fabiobaltieri/quakelight/hardware/quakelight.kicad_pcb

## KiCad design hardware/quakelight.kicad_pcb (2025-12-25)

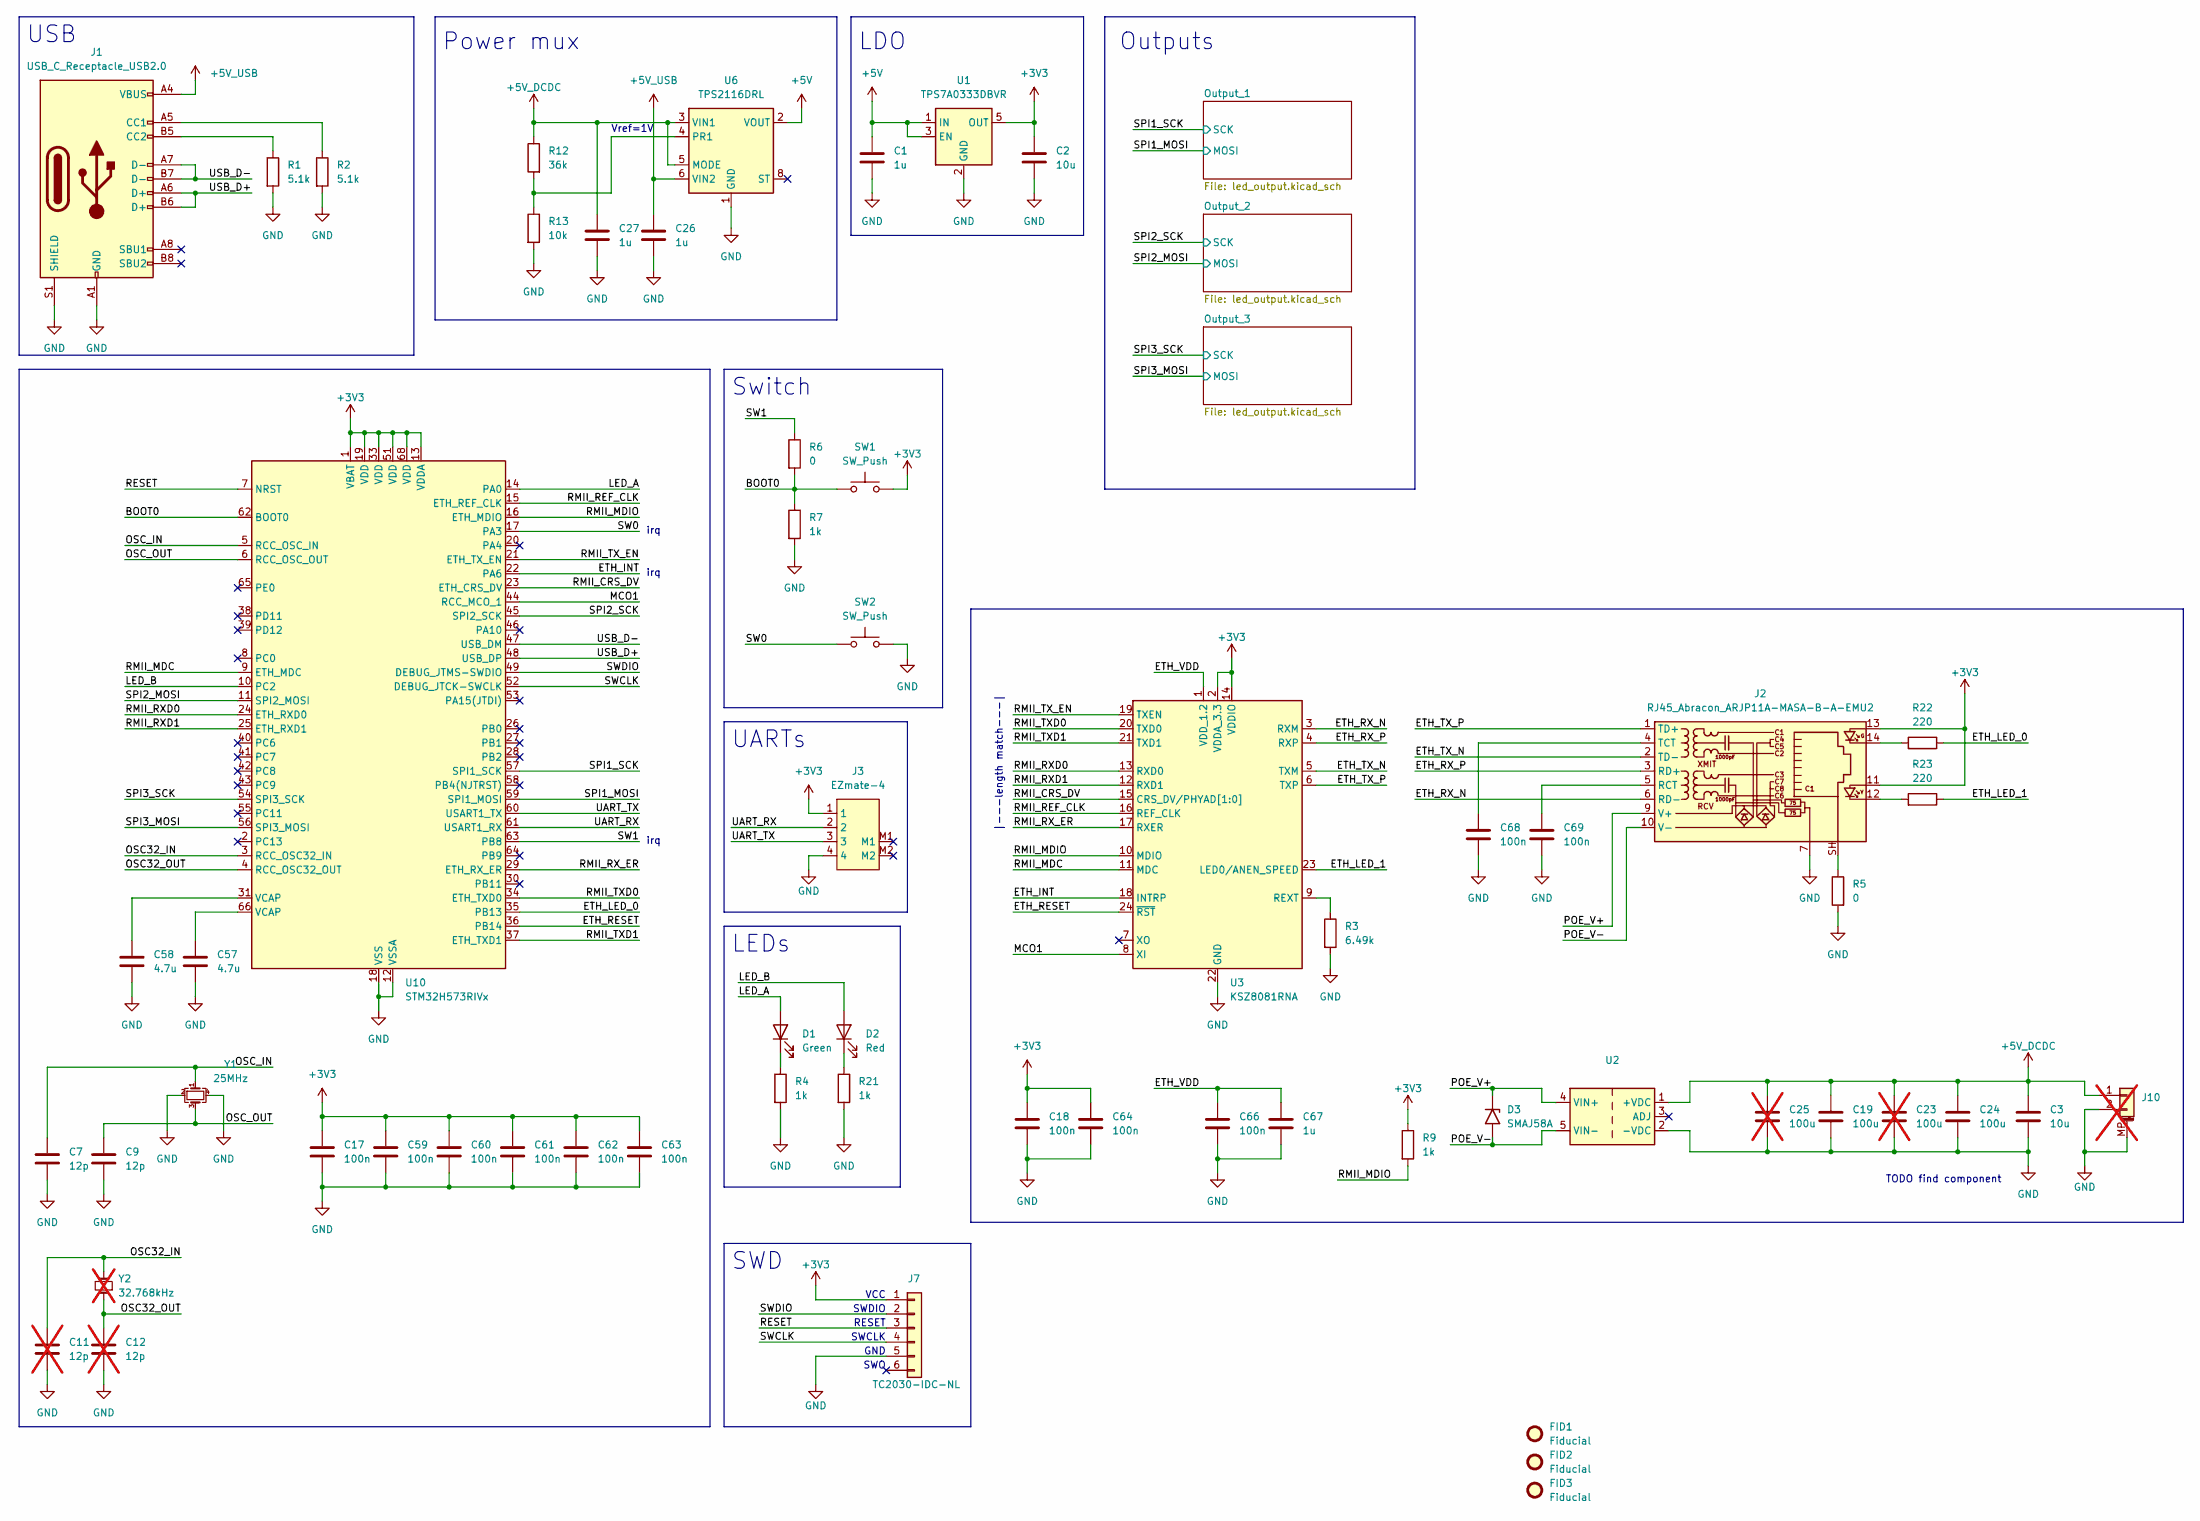
[picture p1: schematic quakelight.kicad_sch]

Parts:
C1, C26, C27, C67: 1u; C_0402_Worthington
C2, C3: 10u; C_0402_Worthington
C7, C9: 12p; C_0402_Worthington
C11, C12: 12p; C_0402_Worthington; not fitted
C17, C18, C59, C60, C61, C62, C63, C64, C66, C68, C69: 100n; C_0402_Worthington
C19, C24: 100u; C_1206_3216Metric
C23, C25: 100u; C_1206_3216Metric; not fitted
C57, C58: 4.7u; C_0402_Worthington
D1: Green; LED_0402_Worthington
D2: Red; LED_0402_Worthington
D3: SMAJ58A; D_SMA
FID1, FID2, FID3: Fiducial; Fiducial_0.75mm_Mask1.5mm
J1: USB_C_Receptacle_USB2.0; USB_C_Receptacle_JAE_DX07S016JA1R1500
J2: RJ45_Abracon_ARJP11A-MASA-B-A-EMU2; RJ45_Abracon_ARJP11A-MA_Horizontal
J3: EZmate-4
J7: TC2030-IDC-NL; Tag-Connect_TC2030-IDC-NL_2x03_P1.27mm_Vertical
J10: Conn_01x02_MountingPin; JST_PH_S2B-PH-SM4-TB_1x02-1MP_P2.00mm_Horizontal; not fitted
R1, R2: 5.1k; R_0402_Worthington
R3: 6.49k; R_0402_Worthington
R4, R7, R9, R21: 1k; R_0402_Worthington
R5: 0; R_0805_2012Metric
R6: 0; R_0402_Worthington
R12: 36k; R_0402_Worthington
R13: 10k; R_0402_Worthington
R22, R23: 220; R_0402_Worthington
SW1, SW2: SW_Push; SW_Push_1P1T_NO_Vertical_Wuerth_434133025816
U1: TPS7A0333DBVR; SOT-23-5
U2: AG9900-MTB
U3: KSZ8081RNA; QFN-24-1EP_4x4mm_P0.5mm_EP2.6x2.6mm
U6: TPS2116DRL; SOT-583-8
U10: STM32H573RIVx; QFN-68-1EP_8x8mm_P0.4mm_EP6.4x6.4mm
Y1: 25MHz; Crystal_SMD_2016-4Pin_2.0x1.6mm
Y2: 32.768kHz; Crystal_SMD_2012-2Pin_2.0x1.2mm; not fitted

Connections:
+3V3: C2.1, C17.1, C18.1, C59.1, C60.1, C61.1, C62.1, C63.1, C64.1, J2.11, J2.13, J3.1, J7.1, R9.1, SW1.2, U1.5 (OUT), U3.2 (VDDA_3.3), U3.14 (VDDIO), U10.1 (VBAT), U10.13 (VDDA), U10.19 (VDD), U10.33 (VDD), U10.51 (VDD), U10.68 (VDD); also elsewhere on the board
+5V: C1.1, U1.1 (IN), U1.3 (EN), U6.2 (VOUT), U6.7 (VOUT); also elsewhere on the board
+5V_DCDC: C3.1, C19.1, C23.1, C24.1, C25.1, C27.1, J10.1, R12.1, U2.1 (+VDC), U6.3 (VIN1), U6.5 (MODE)
+5V_USB: C26.1, J1.A4 (VBUS), J1.A9 (VBUS), J1.B4 (VBUS), J1.B9 (VBUS), U6.6 (VIN2)
/BOOT0: R6.2, R7.1, SW1.1, U10.62 (BOOT0)
/ETH_INT: U3.18 (INTRP), U10.22 (PA6)
/ETH_LED_0: R22.1, U10.35 (PB13)
/ETH_LED_1: R23.1, U3.23 (LED0/ANEN_SPEED)
/ETH_RESET: U3.24 (~RST), U10.36 (PB14)
/ETH_RX_N: J2.6 (RD-), U3.3 (RXM)
/ETH_RX_P: J2.3 (RD+), U3.4 (RXP)
/ETH_TX_N: J2.2 (TD-), U3.5 (TXM)
/ETH_TX_P: J2.1 (TD+), U3.6 (TXP)
/ETH_VDD: C66.1, C67.1, U3.1 (VDD_1.2)
/LED_A: D1.2 (A), U10.14 (PA0)
/LED_B: D2.2 (A), U10.10 (PC2)
/MCO1: U3.8 (XI), U10.44 (RCC_MCO_1)
/OSC32_IN: C11.1, U10.3 (RCC_OSC32_IN), Y2.2
/OSC32_OUT: C12.1, U10.4 (RCC_OSC32_OUT), Y2.1
/OSC_IN: C7.1, U10.5 (RCC_OSC_IN), Y1.1
/OSC_OUT: C9.1, U10.6 (RCC_OSC_OUT), Y1.3
/POE_V+: D3.1 (A1), J2.9 (V+), U2.4 (VIN+)
/POE_V-: D3.2 (A2), J2.10 (V-), U2.5 (VIN-)
/RESET: J7.3, U10.7 (NRST)
/RMII_CRS_DV: U3.15 (CRS_DV/PHYAD[1:0]), U10.23 (ETH_CRS_DV)
/RMII_MDC: U3.11 (MDC), U10.9 (ETH_MDC)
/RMII_MDIO: R9.2, U3.10 (MDIO), U10.16 (ETH_MDIO)
/RMII_REF_CLK: U3.16 (REF_CLK), U10.15 (ETH_REF_CLK)
/RMII_RXD0: U3.13 (RXD0), U10.24 (ETH_RXD0)
/RMII_RXD1: U3.12 (RXD1), U10.25 (ETH_RXD1)
/RMII_RX_ER: U3.17 (RXER), U10.29 (ETH_RX_ER)
/RMII_TXD0: U3.20 (TXD0), U10.34 (ETH_TXD0)
/RMII_TXD1: U3.21 (TXD1), U10.37 (ETH_TXD1)
/RMII_TX_EN: U3.19 (TXEN), U10.21 (ETH_TX_EN)
/SPI1_MOSI: U10.59 (SPI1_MOSI); also elsewhere on the board
/SPI1_SCK: U10.57 (SPI1_SCK); also elsewhere on the board
/SPI2_MOSI: U10.11 (SPI2_MOSI); also elsewhere on the board
/SPI2_SCK: U10.45 (SPI2_SCK); also elsewhere on the board
/SPI3_MOSI: U10.56 (SPI3_MOSI); also elsewhere on the board
/SPI3_SCK: U10.54 (SPI3_SCK); also elsewhere on the board
/SW0: SW2.1, U10.17 (PA3)
/SW1: R6.1, U10.63 (PB8)
/SWCLK: J7.4, U10.52 (DEBUG_JTCK-SWCLK)
/SWDIO: J7.2, U10.49 (DEBUG_JTMS-SWDIO)
/UART_RX: J3.2, U10.61 (USART1_RX)
/UART_TX: J3.3, U10.60 (USART1_TX)
/USB_D+: J1.A6 (D+), J1.B6 (D+), U10.48 (USB_DP)
/USB_D-: J1.A7 (D-), J1.B7 (D-), U10.47 (USB_DM)
GND: C1.2, C2.2, C3.2, C7.2, C9.2, C11.2, C12.2, C17.2, C18.2, C19.2, C23.2, C24.2, C25.2, C26.2, C27.2, C57.2, C58.2, C59.2, C60.2, C61.2, C62.2, C63.2, C64.2, C66.2, C67.2, C68.2, C69.2, J1.A1 (GND), J1.A12 (GND), J1.B1 (GND), J1.B12 (GND), J1.S1 (SHIELD), J2.7, J3.4, J7.5, J10.2, J10.MP (MountPin), R1.2, R2.2, R3.2, R4.2, R5.2, R7.2, R13.2, R21.2, SW2.2, U1.2 (GND), U2.2 (-VDC), U3.22 (GND), U3.25 (GND), U6.1 (GND), U10.12 (VSSA), U10.18 (VSS), U10.32 (VSS), U10.50 (VSS), U10.67 (VSS), U10.69 (VSS), Y1.2, Y1.4; also elsewhere on the board
unnamed: C57.1, U10.66 (VCAP)
unnamed: C58.1, U10.31 (VCAP)
unnamed: D1.1 (K), R4.1
unnamed: D2.1 (K), R21.1
unnamed: J1.A5 (CC1), R2.1
unnamed: J1.B5 (CC2), R1.1
unnamed: J2.12, R23.2
unnamed: J2.14, R22.2
unnamed: J2.SH, R5.1
unnamed: C69.1, J2.5 (RCT)
unnamed: C68.1, J2.4 (TCT)
unnamed: R3.1, U3.9 (REXT)
unnamed: R12.2, R13.1, U6.4 (PR1)

Notes on the sheet:
RESET
Outputs
irq
USB
SWD
|---length match---|
LEDs
SWDIO
TODO find component
GND
SWO
Switch
Vref=1V
SWCLK
Power mux
LDO
UARTs
VCC

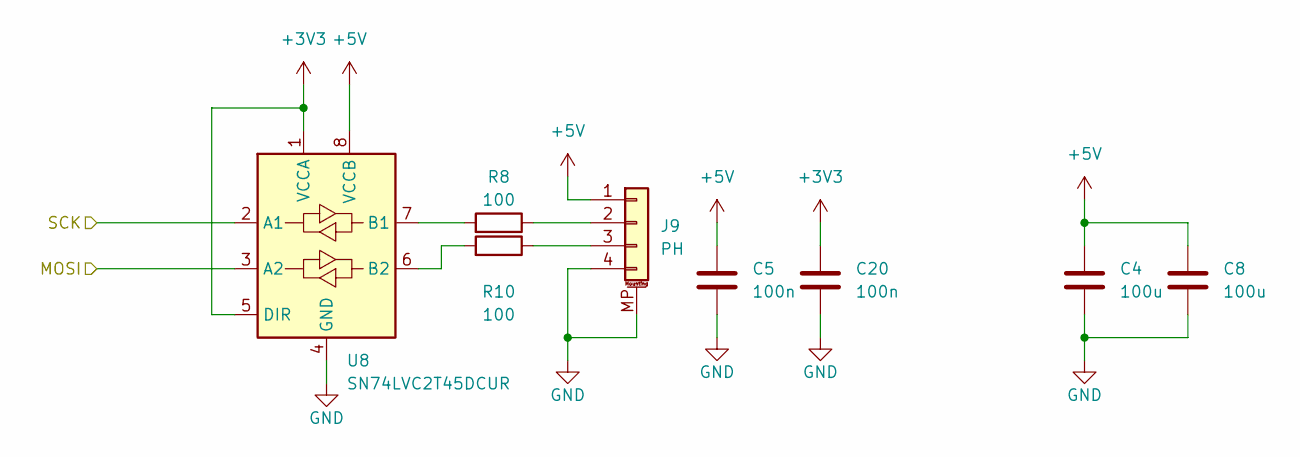
[picture p2: schematic led_output.kicad_sch]

Parts:
C4, C8: 100u; C_1206_3216Metric
C5, C20: 100n; C_0402_Worthington
J9: PH; JST_PH_S4B-PH-SM4-TB_1x04-1MP_P2.00mm_Horizontal
R8, R10: 100; R_0402_Worthington
U8: SN74LVC2T45DCUR; VSSOP-8_2.3x2mm_P0.5mm

Connections:
+3V3: C20.1, U8.1 (VCCA), U8.5 (DIR); also elsewhere on the board
+5V: C4.1, C5.1, C8.1, J9.1, U8.8 (VCCB); also elsewhere on the board
/SPI1_MOSI: U8.3 (A2); also elsewhere on the board
/SPI1_SCK: U8.2 (A1); also elsewhere on the board
GND: C4.2, C5.2, C8.2, C20.2, J9.4, J9.MP (MountPin), U8.4 (GND); also elsewhere on the board
unnamed: J9.2, R8.1
unnamed: J9.3, R10.1
unnamed: R8.2, U8.7 (B1)
unnamed: R10.2, U8.6 (B2)

Parts of its further copies:
C6, C10, C21, C22: 100n; C_0402_Worthington
C13, C14, C15, C16: 100u; C_1206_3216Metric
J4, J5: PH; JST_PH_S4B-PH-SM4-TB_1x04-1MP_P2.00mm_Horizontal
R11, R14, R15, R16: 100; R_0402_Worthington
U4, U5: SN74LVC2T45DCUR; VSSOP-8_2.3x2mm_P0.5mm

Connections of its further copies:
+3V3: C21.1, C22.1, U4.1 (VCCA), U4.5 (DIR), U5.1 (VCCA), U5.5 (DIR); also elsewhere on the board
+5V: C6.1, C10.1, C13.1, C14.1, C15.1, C16.1, J4.1, J5.1, U4.8 (VCCB), U5.8 (VCCB); also elsewhere on the board
/SPI2_MOSI: U4.3 (A2); also elsewhere on the board
/SPI2_SCK: U4.2 (A1); also elsewhere on the board
/SPI3_MOSI: U5.3 (A2); also elsewhere on the board
/SPI3_SCK: U5.2 (A1); also elsewhere on the board
GND: C6.2, C10.2, C13.2, C14.2, C15.2, C16.2, C21.2, C22.2, J4.4, J4.MP (MountPin), J5.4, J5.MP (MountPin), U4.4 (GND), U5.4 (GND); also elsewhere on the board
unnamed: J4.2, R11.1
unnamed: J4.3, R14.1
unnamed: J5.2, R15.1
unnamed: J5.3, R16.1
unnamed: R11.2, U4.7 (B1)
unnamed: R14.2, U4.6 (B2)
unnamed: R15.2, U5.7 (B1)
unnamed: R16.2, U5.6 (B2)

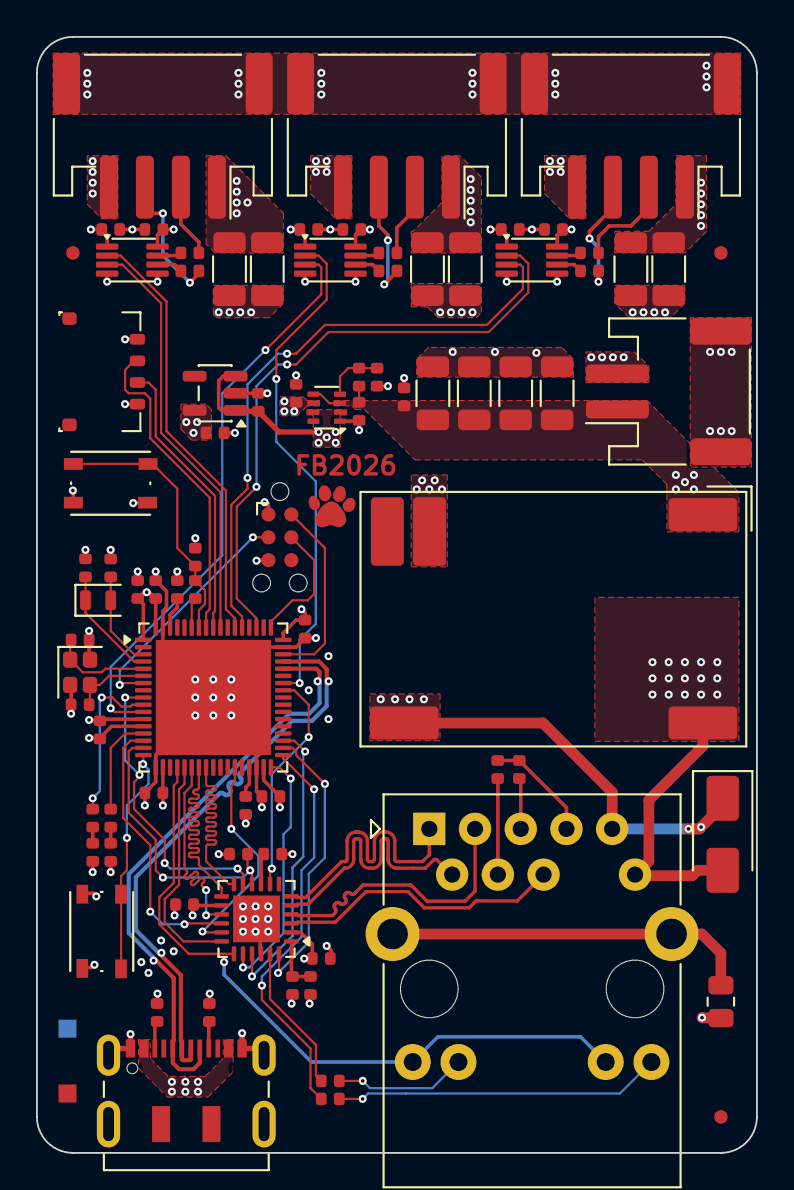
[picture p3: board quakelight.kicad_pcb from above]

Board: 4 copper layers, 40.0 x 62.0 mm, 84 parts (0 on the bottom side), 74 nets.
