fabiobaltieri/quakelight/firmware/src/wifi_creds.c

#include <zephyr/init.h>
#include <zephyr/kernel.h>
#include <zephyr/logging/log.h>
#include <zephyr/net/net_core.h>
#include <zephyr/net/net_if.h>
#include <zephyr/net/net_mgmt.h>
#include <zephyr/net/net_mgmt.h>
#include <zephyr/net/wifi_mgmt.h>

LOG_MODULE_REGISTER(wifi_creds, LOG_LEVEL_INF);

#define WIFI_CONN_RETRY_SECS 5

static void wifi_conn_handler(struct k_work *work);

K_WORK_DELAYABLE_DEFINE(wifi_conn_dwork, wifi_conn_handler);

static void wifi_conn_handler(struct k_work *work)
{
	struct net_if *iface = net_if_get_first_wifi();
	struct wifi_iface_status status = {0};
	int ret;

	ret = net_mgmt(NET_REQUEST_WIFI_IFACE_STATUS, iface, &status,
		       sizeof(struct wifi_iface_status));
	if (ret != 0) {
		LOG_WRN("Status request failed: %d", ret);
		goto out;
	}

	if (status.state == WIFI_STATE_DISCONNECTED ||
	    status.state == WIFI_STATE_INACTIVE) {
		LOG_INF("Trying to connect");
		ret = net_mgmt(NET_REQUEST_WIFI_CONNECT_STORED, iface, NULL, 0);
		if (ret != 0) {
			LOG_WRN("Autoconnect failed: %d", ret);
		}
	} else if (status.state >= WIFI_STATE_ASSOCIATED) {
		goto out;
	} else {
		LOG_INF("WiFi status: %s", wifi_state_txt(status.state));
	}

out:
	k_work_schedule(&wifi_conn_dwork, K_SECONDS(WIFI_CONN_RETRY_SECS));
}

static int wifi_conn(void)
{
	k_work_schedule(&wifi_conn_dwork, K_SECONDS(WIFI_CONN_RETRY_SECS));

	return 0;
}
SYS_INIT(wifi_conn, APPLICATION, 91);
