fabiobaltieri/quakelight/(commit log)

2025-12-21 hw: move output on separate sheet
    [led_output.kicad_sch, quakelight.kicad_pcb, quakelight.kicad_sch]
2025-12-25 fw: add quakelight board
2025-12-25 hw: 3d model update
    [quakelight.kicad_pcb]
2025-12-25 fw: add led dev check
2025-12-25 fw: enable sensors
2025-12-25 fw: add i2s channel to esp32c3
2025-12-25 fw: add rpi pico config
2025-12-25 fw: use real spi and dma for rp2040
2026-01-01 hw: add few notes
    [quakelight.kicad_sch]
2026-01-17 hw: dnp update
    [quakelight.kicad_sch]
2026-02-12 fw: add leds.c
2026-02-12 fw: add few num_pixel check, fix compiler warning
    [leds.c]
2026-02-12 build: add few more boards
